drtonis/5.65inch-E-ink-Photoframe/README.md

# 5.65inch-E-ink-Photoframe

more info in Instructables
https://www.instructables.com/E-paper-Picture-Frame/
