drtonis/5.65inch-E-ink-Photoframe/PCB/BOM_PCB_E-paper_2023-04-05.csv

ID | Name | Designator | Footprint | Quantity | Manufacturer Part | Manufacturer | Supplier | Supplier Part | Price
1 | KT-0603R | LED_A,LED_ACT,LED_B,LED_C,LED_CON,LED_D,LED_E | LED0603-RD | 7 | KT-0603R | null | LCSC | C2286
2 | TS-1187A-B-A-B | RESET,SW_A,SW_B,SW_C,SW_D,SW_E | SW-SMD_4P-L5.1-W5.1-P3.70-LS6.5-TL-2 | 6 | TS-1187A-B-A-B | XKB Connectivity(中国星坤) | LCSC | C318884 | 0.003
3 | M3 | G1,G2,G3,G4 | M3 CHASSIS | 4
4 | CR2032-BS-8-1 | B1 | BAT-TH_BS-8-1 | 1 | BS-8-1 | Q&J | LCSC | C70378 | 0.038
5 | 4.7uF | C1,C7,C8,C9,C10,C11,C12,C13,C31,C38 | C0805 | 10 | CL21A475KAQNNNE | SAMSUNG(三星) | LCSC | C1779 | 0.002
6 | 1uF | C2,C5,C14,C15,C16,C17,C19,C20,C21,C28,C29,C36,C37,C39,C40,C41,C30,C42 | C0603 | 18 | CL10A105KB8NNNC | SAMSUNG(三星) | LCSC | C15849 | 0.001
7 | 100nF | C3,C4,C43 | C0603 | 3 | CC0603KRX7R9BB104 | YAGEO(国巨) | LCSC | C14663
8 | 10uF | C6,C18,C23,C24,C25,C26,C27,C32,C33,C34,C35,C22 | C0805 | 12 | CL21A106KAYNNNE | SAMSUNG(三星) | LCSC | C15850 | 0.002
9 | TF-01A | CARD1 | TF-SMD_TF-01A | 1 | TF-01A | 韩国韩荣 | LCSC | C91145 | 0.029
10 | BAT54C,215 | D1,D2,D3,D4 | SOT-23-3_L2.9-W1.6-P1.90-LS2.8-BR | 4 | BAT54C,215 | Nexperia(安世) | LCSC | C37704 | 0.003
11 | BAV99,215 | D5,D6,D7,D8,D9 | SOT-23-3_L2.9-W1.6-P1.90-LS2.8-BR | 5 | BAV99,215 | Nexperia(安世) | LCSC | C2500 | 0.004
12 | AYF532435_C425161 | FPC1,FPC3 | FPC-SMD_24P-P0.50_PANASONIC_AYF532435 | 2 | AYF532435 | PANASONIC(松下) | LCSC | C425161 | 0.055
13 | XF3M-5015-1B | FPC2 | FPC-SMD_50P-P0.50_L6.4-W28.1 | 1 | XF3M-5015-1B | OMRON(欧姆龙) | LCSC | C231436 | 0.111
14 | 10uH | L1,L2,L3 | IND-SMD_L4.0-W4.0_SMNR4012 | 3 | NRS4018T100MDGJ | TAIYO YUDEN(太诱) | LCSC | C222882 | 0.013
15 | AO3401A | Q1,Q3,Q7,Q8 | SOT-23_L2.9-W1.3-P1.90-LS2.4-BR | 4 | AO3401A | AOS | LCSC | C15127 | 0.013
16 | AO3400A | Q2,Q5,Q6 | SOT-23-3_L2.9-W1.6-P1.90-LS2.8-BR | 3 | AO3400A | AOS | LCSC | C20917 | 0.013
17 | 1MΩ | R2,R4,R19 | R0603 | 3 | 0603WAF1004T5E | UNI-ROYAL(厚声) | LCSC | C22935
18 | 150kΩ | R3,R15,R16 | R0603 | 3 | 0603WAF1503T5E | UNI-ROYAL(厚声) | LCSC | C22807
19 | 10kΩ | R5,R8 | R0603 | 2 | 0603WAF1002T5E | UNI-ROYAL(厚声) | LCSC | C25804
20 | 0.47Ω | R6,R7,R17 | R0603 | 3 | CR0603FR470P05Z | EVER OHMS(天二科技) | LCSC | C175657 | 0.001
21 | 0Ω | R10,R11,R12,R13,R23,R24,R25,R26,R20,R21 | R0603 | 10 | 0603WAF0000T5E | UNI-ROYAL(厚声) | LCSC | C21189
22 | 10kΩ | RN1,RN2,RN3 | RES-ARRAY-SMD_0603-8P-L3.2-W1.6-BL | 3 | 4D03WGJ0103T5E | UNI-ROYAL(厚声) | LCSC | C29718 | 0.001
23 | 1kΩ | RN4,RN5 | RES-ARRAY-SMD_0603-8P-L3.2-W1.6-BL | 2 | 4D03WGJ0102T5E | UNI-ROYAL(厚声) | LCSC | C20197 | 0.001
24 | PCF85063AT/AAZ | U1 | SO-8_L4.9-W3.9-P1.27-LS5.9-BL | 1 | PCF85063AT/AAZ | NXP(恩智浦) | LCSC | C2157792 | 0.121
25 | 74HC165D,653 | U2 | SOIC-16_L9.9-W3.9-P1.27-LS6.0-BL | 1 | 74HC165D,653 | Nexperia(安世) | LCSC | C5613 | 0.033
26 | AP2138N-3.3TRG1 | U4 | SOT-23-3_L2.9-W1.3-P1.90-LS2.4-BR | 1 | AP2138N-3.3TRG1 | DIODES(美台) | LCSC | C154771 | 0.047
27 | 32.768kHz | X1 | FC-135R_L3.2-W1.5 | 1 | Q13FC1350000400 | EPSON(爱普生) | LCSC | C32346 | 0.033
28 | 56kΩ | R9 | R0603 | 1 | 0603WAF5602T5E | UNI-ROYAL(厚声) | LCSC | C23206
