drtonis/5.65inch-E-ink-Photoframe/STL/5in65_Ribbat_14x14_A.stl

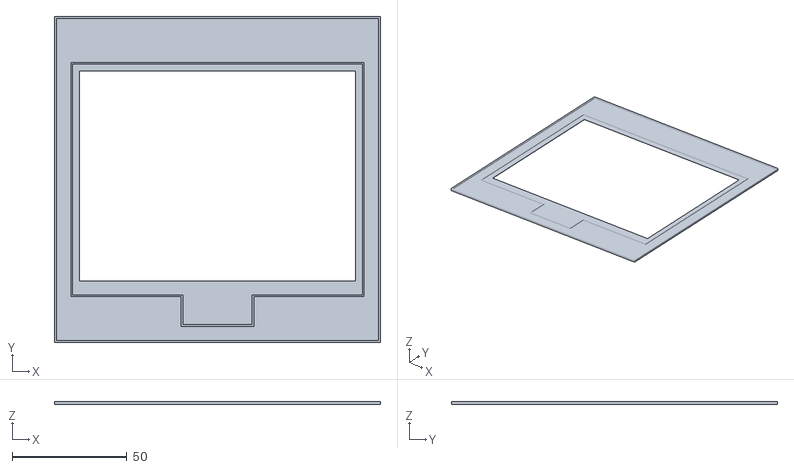
[picture p1: CAD file, 2023-04-05]
STL/5in65_Ribbat_14x14_A.stl
142.0 x 142.0 x 1.40
