drtonis/5.65inch-E-ink-Photoframe/STL/5in65_Ribbat_14x14_C.stl

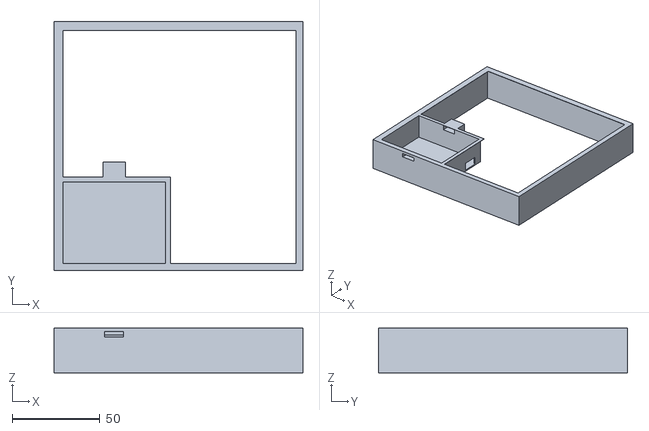
[picture p2: CAD file, 2023-04-05]
STL/5in65_Ribbat_14x14_C.stl
142.0 x 142.0 x 25.4
