drtonis/5.65inch-E-ink-Photoframe/STL/5in65_Ribbat_14x14_D.stl

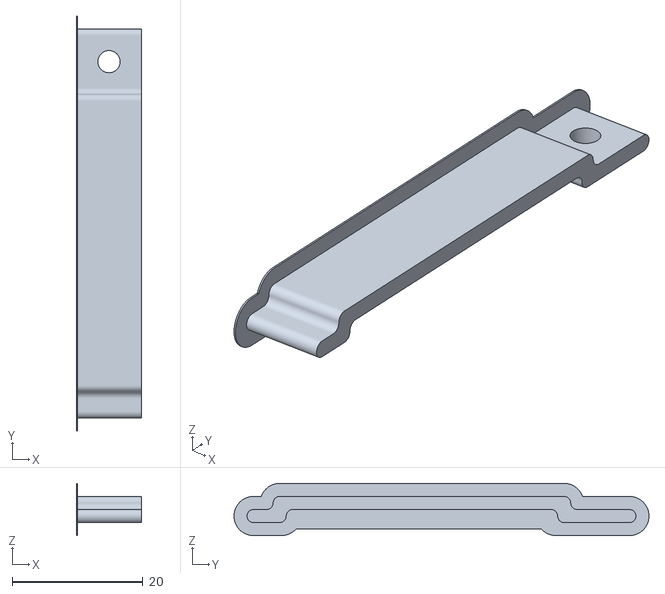
[picture p3: CAD file, 2023-04-05]
STL/5in65_Ribbat_14x14_D.stl
10.0 x 63.6 x 8.00
