drtonis/5.65inch-E-ink-Photoframe/PCB/Schematic_E-paper_2023-04-05.pdf

# DS 10 D0 11 D1 12 D2 13 D3 14 CE# 15 VCC 16

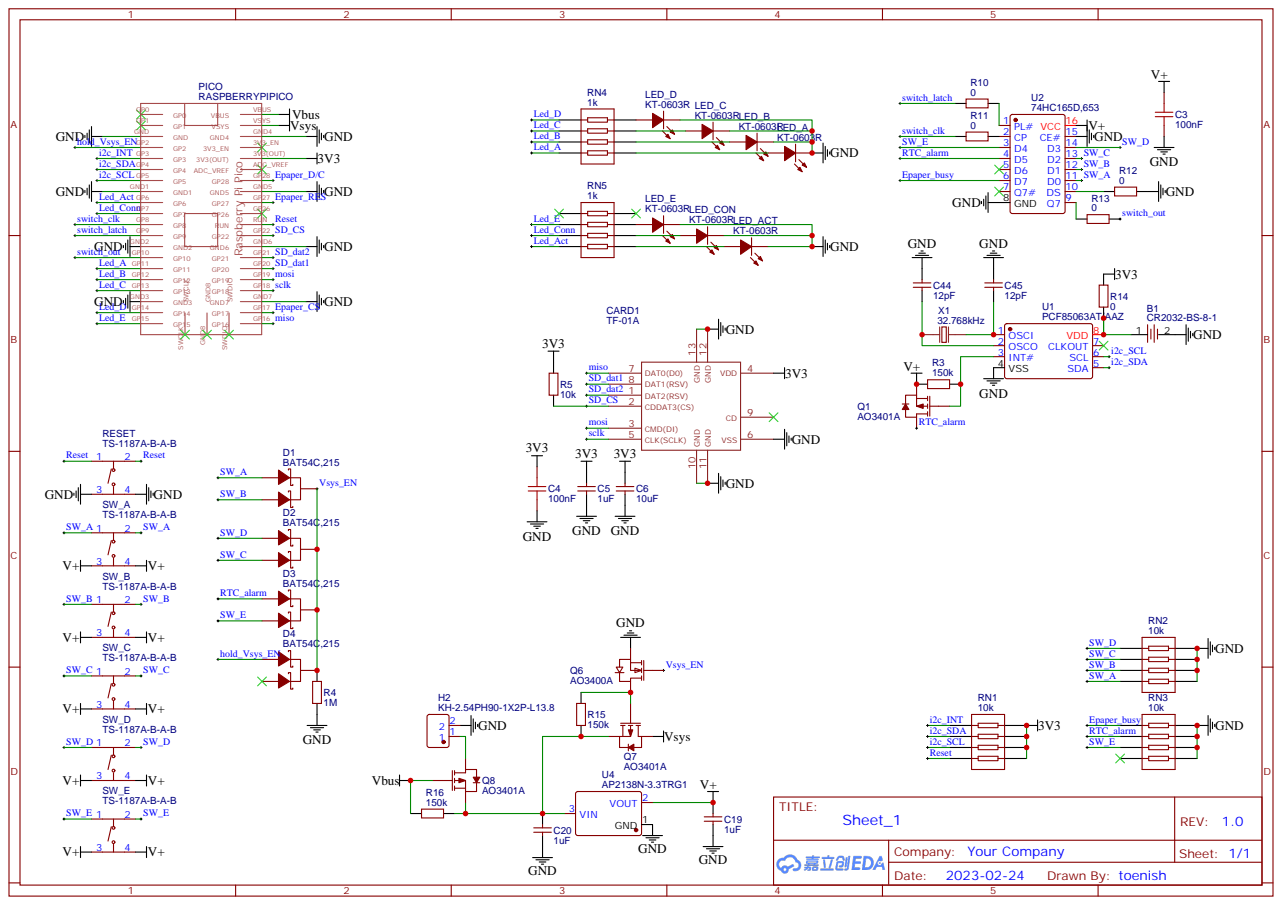
[picture p5: page 1]

# VSH1 VPP/REFN

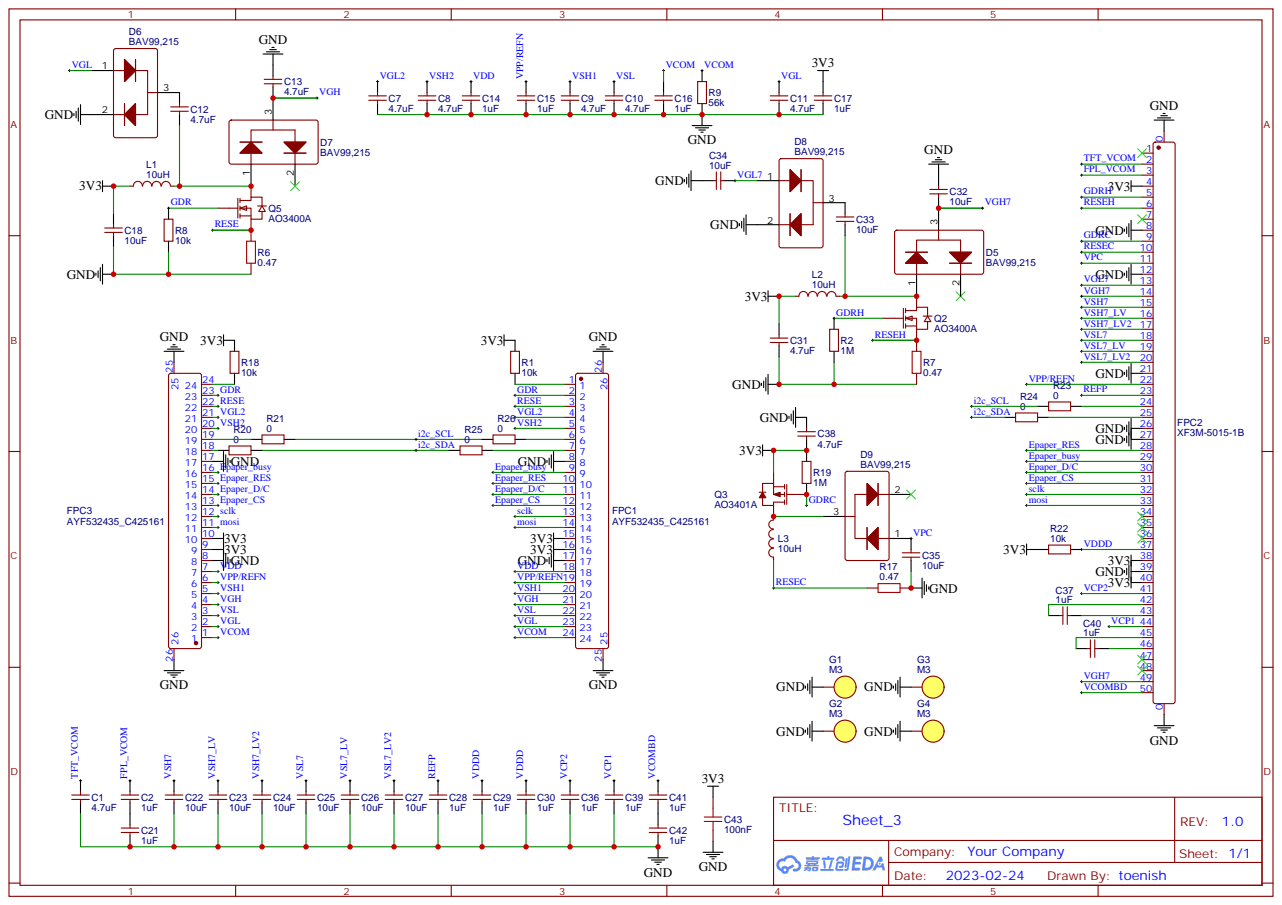
[picture p6: page 2]
